dss-loris/battery-board-prototype/battery-board-BOM.xlsx

Index | Quantity | Part Number | Manufacturer Part Number | Description | Customer Reference | Available | Backorder | Unit Price | Extended Price USD
1 | 4 | DB2431200LCT-ND | DB2431200L | DIODE SCHOTTKY 30V 5A TMINIP2 | D1,D2 … BB | 4 | 0 | 0.42 | 1.68
2 | 2 | 2057-2PH1-05-UA-ND | 2PH1-05-UA | CONN HEADER VERT 5POS 2MM | J5,J9 … BB | 2 | 0 | 0.18 | 0.36
3 | 2 | 2057-2PH1-04-UA-ND | 2PH1-04-UA | CONN HEADER VERT 4POS 2MM | J3 … BB | 2 | 0 | 0.14 | 0.28
4 | 2 | 952-1316-ND | M22-2511005 | CONN HEADER VERT 10POS 2MM | J1,J4,CDR1,GND1,MPB1 … BB | 2 | 0 | 0.61 | 1.22
5 | 2 | LM4120AIM5-5.0/NOPBCT-ND | LM4120AIM5-5.0/NOPB | IC VREF SERIES 0.2% SOT23-5 | U1 … BB | 2 | 0 | 2.19 | 4.38
6 | 2 | WM4000-ND | 0022032021 | CONN HEADER VERT 2POS 2.54MM | JP1,JP2 … BB | 2 | 0 | 0.25 | 0.50
7 | 10 | 399-C1206C104K5RAC7800CT-ND | C1206C104K5RAC7800 | CAP CER 0.1UF 50V X7R 1206 | C2,C3,C4,C8,10 … BB | 10 | 0 | 0.088 | 0.88
8 | 2 | 1849-1001-ND | PR20C06VBNN | CONN HEADER VERT 6POS 2MM | J2,J8 … BB | 2 | 0 | 0.16 | 0.32
9 | 2 | 399-8150-1-ND | C1206C105M4RACTU | CAP CER 1UF 16V X7R 1206 | C9 … BB | 2 | 0 | 0.19 | 0.38
10 | 3 | 408-2038-1-ND | RG3216P-5004-B-T1 | RES 5M OHM 0.1% 1/4W 1206 | R4,R5 … BB | 3 | 0 | 0.76 | 2.28
11 | 1 | 36-1042-ND | 1042 | BATTERY HOLDER 18650 SMD TAB | BT1 … BB | 1 | 0 | 2.76 | 2.76
12 | 2 | 399-9329-1-ND | C1206C223J1RACTU | CAP CER 0.022UF 100V X7R 1206 | C1 … BB | 2 | 0 | 0.2 | 0.40
13 | 3 | 399-1251-1-ND | C1206C224K5RACTU | CAP CER 0.22UF 50V X7R 1206 | C5,C7 … BB | 3 | 0 | 0.23 | 0.69
14 | 2 | 311-2007-1-ND | CC1206ZRY5V6BB106 | CAP CER 10UF 10V Y5V 1206 | C6 … BB | 2 | 0 | 0.23 | 0.46
15 | 3 | 732-5316-ND | 61300311121 | CONN HEADER VERT 3POS 2.54MM | J6,J7 … BB | 3 | 0 | 0.13 | 0.39
16 | 5 | RG32P887KBCT-ND | RG3216P-8873-B-T1 | RES SMD 887K OHM 0.1% 1/4W 1206 | R1,R2,R8 … BB | 5 | 0 | 0.68 | 3.40
17 | 2 | P2.2KECT-ND | ERJ-8GEYJ222V | RES SMD 2.2K OHM 5% 1/4W 1206 | R3 … BB | 2 | 0 | 0.1 | 0.20
18 | 2 | P4.87KFCT-ND | ERJ-8ENF4871V | RES SMD 4.87K OHM 1% 1/4W 1206 | R6 … BB | 2 | 0 | 0.1 | 0.20
19 | 2 | P330FCT-ND | ERJ-8ENF3300V | RES SMD 330 OHM 1% 1/4W 1206 | R7 … BB | 2 | 0 | 0.1 | 0.20
20 | 2 | RNCP1206FTD28K0CT-ND | RNCP1206FTD28K0 | RES 28K OHM 1% 1/2W 1206 | R9 … BB | 2 | 0 | 0.1 | 0.20
21 | 4 | P332KFCT-ND | ERJ-8ENF3323V | RES SMD 332K OHM 1% 1/4W 1206 | R19,R22 … BB | 4 | 0 | 0.1 | 0.40
22 | 5 | P187KBCCT-ND | ERA-8AEB1873V | RES SMD 187K OHM 0.1% 1/4W 1206 | R0,R11,R24 … BB | 5 | 0 | 0.66 | 3.30
23 | 2 | 311-1.62MFRCT-ND | RC1206FR-071M62L | RES SMD 1.62M OHM 1% 1/4W 1206 | R12 … BB | 2 | 0 | 0.1 | 0.20
24 | 2 | P374KFCT-ND | ERJ-8ENF3743V | RES SMD 374K OHM 1% 1/4W 1206 | R13 … BB | 2 | 0 | 0.1 | 0.20
25 | 2 | RMCF0805FT1M43CT-ND | RMCF0805FT1M43 | RES 1.43M OHM 1% 1/8W 0805 | R14 … BB | 2 | 0 | 0.1 | 0.20
26 | 2 | P562KFCT-ND | ERJ-8ENF5623V | RES SMD 562K OHM 1% 1/4W 1206 | R15 … BB | 2 | 0 | 0.1 | 0.20
27 | 2 | WSLPB-.014CT-ND | WSLP0805R0140FEB | RES 0.014 OHM 1% 1/2W 0805 | R16 … BB | 2 | 0 | 1.27 | 2.54
28 | 2 | RR08P284KDCT-ND | RR0816P-2843-D-E00 | RES SMD 284K OHM 0.5% 1/16W 0603 | R17 … BB | 2 | 0 | 0.13 | 0.26
29 | 3 | P100KFCT-ND | ERJ-8ENF1003V | RES SMD 100K OHM 1% 1/4W 1206 | R18,R23 … BB | 3 | 0 | 0.1 | 0.30
30 | 2 | P29.4KFCT-ND | ERJ-8ENF2942V | RES SMD 29.4K OHM 1% 1/4W 1206 | R20 … BB | 2 | 0 | 0.1 | 0.20
31 | 2 | P59.0KFCT-ND | ERJ-8ENF5902V | RES SMD 59K OHM 1% 1/4W 1206 | R21 … BB | 2 | 0 | 0.1 | 0.20
32 | 2 | 445-174306-1-ND | NTCG103JX103DT1 | THERMISTOR NTC 10KOHM 3380K 0402 | TH1 … BB | 2 | 0 | 0.23 | 0.46
33 | 4 | 296-25857-1-ND | CSD17307Q5A | MOSFET N-CH 30V 73A 8SON | Q1,Q2 … BB | 4 | 0 | 0.76 | 3.04
34 | 2 | LTC2942CDCB#TRMPBFCT-ND | LTC2942CDCB#TRMPBF | IC FUEL/GAS GAUGE LI-ION 6DFN | U2 … BB | 2 | 0 | 3.86 | 7.72
35 | 4 | 296-37669-6-ND | TPS2557DRBR | IC PWR SWITCH N-CHAN 1:1 8SON | U4,U6 … BB | 4 | 0 | 3.89 | 15.56
36 | 2 | 296-13263-1-ND | SN74LVC2G08DCTR | IC GATE AND 2CH 2-INP SM8 | U7 … BB | 2 | 0 | 0.54 | 1.08
37 | 5 | 296-1015-1-ND | LM393DR | IC DUAL DIFF COMP 8-SOIC | U3,U5 … BB | 5 | 0 | 0.38 | 1.90
38 | 5 | 15291025 | 0015291025 | CONN SHUNT CLOSED TOP .100 GOLD | JUMPERS … BB | 5 | 0 | 0.56 | 2.80
39 | 4 | 296-39948-1-ND | BQ29707DSER | IC LITHIUM BATT PROTECT 6WSON | BQ29707 … BB | 4 | 0 | 0.69 | 2.76
