dss-loris/battery-board-prototype/(list of files, drawings)

Other design files:
Main.dsn
