dss-loris/battery-board-prototype/Main.kicad_pcb

## KiCad design Main.kicad_pcb (2020-01-07)

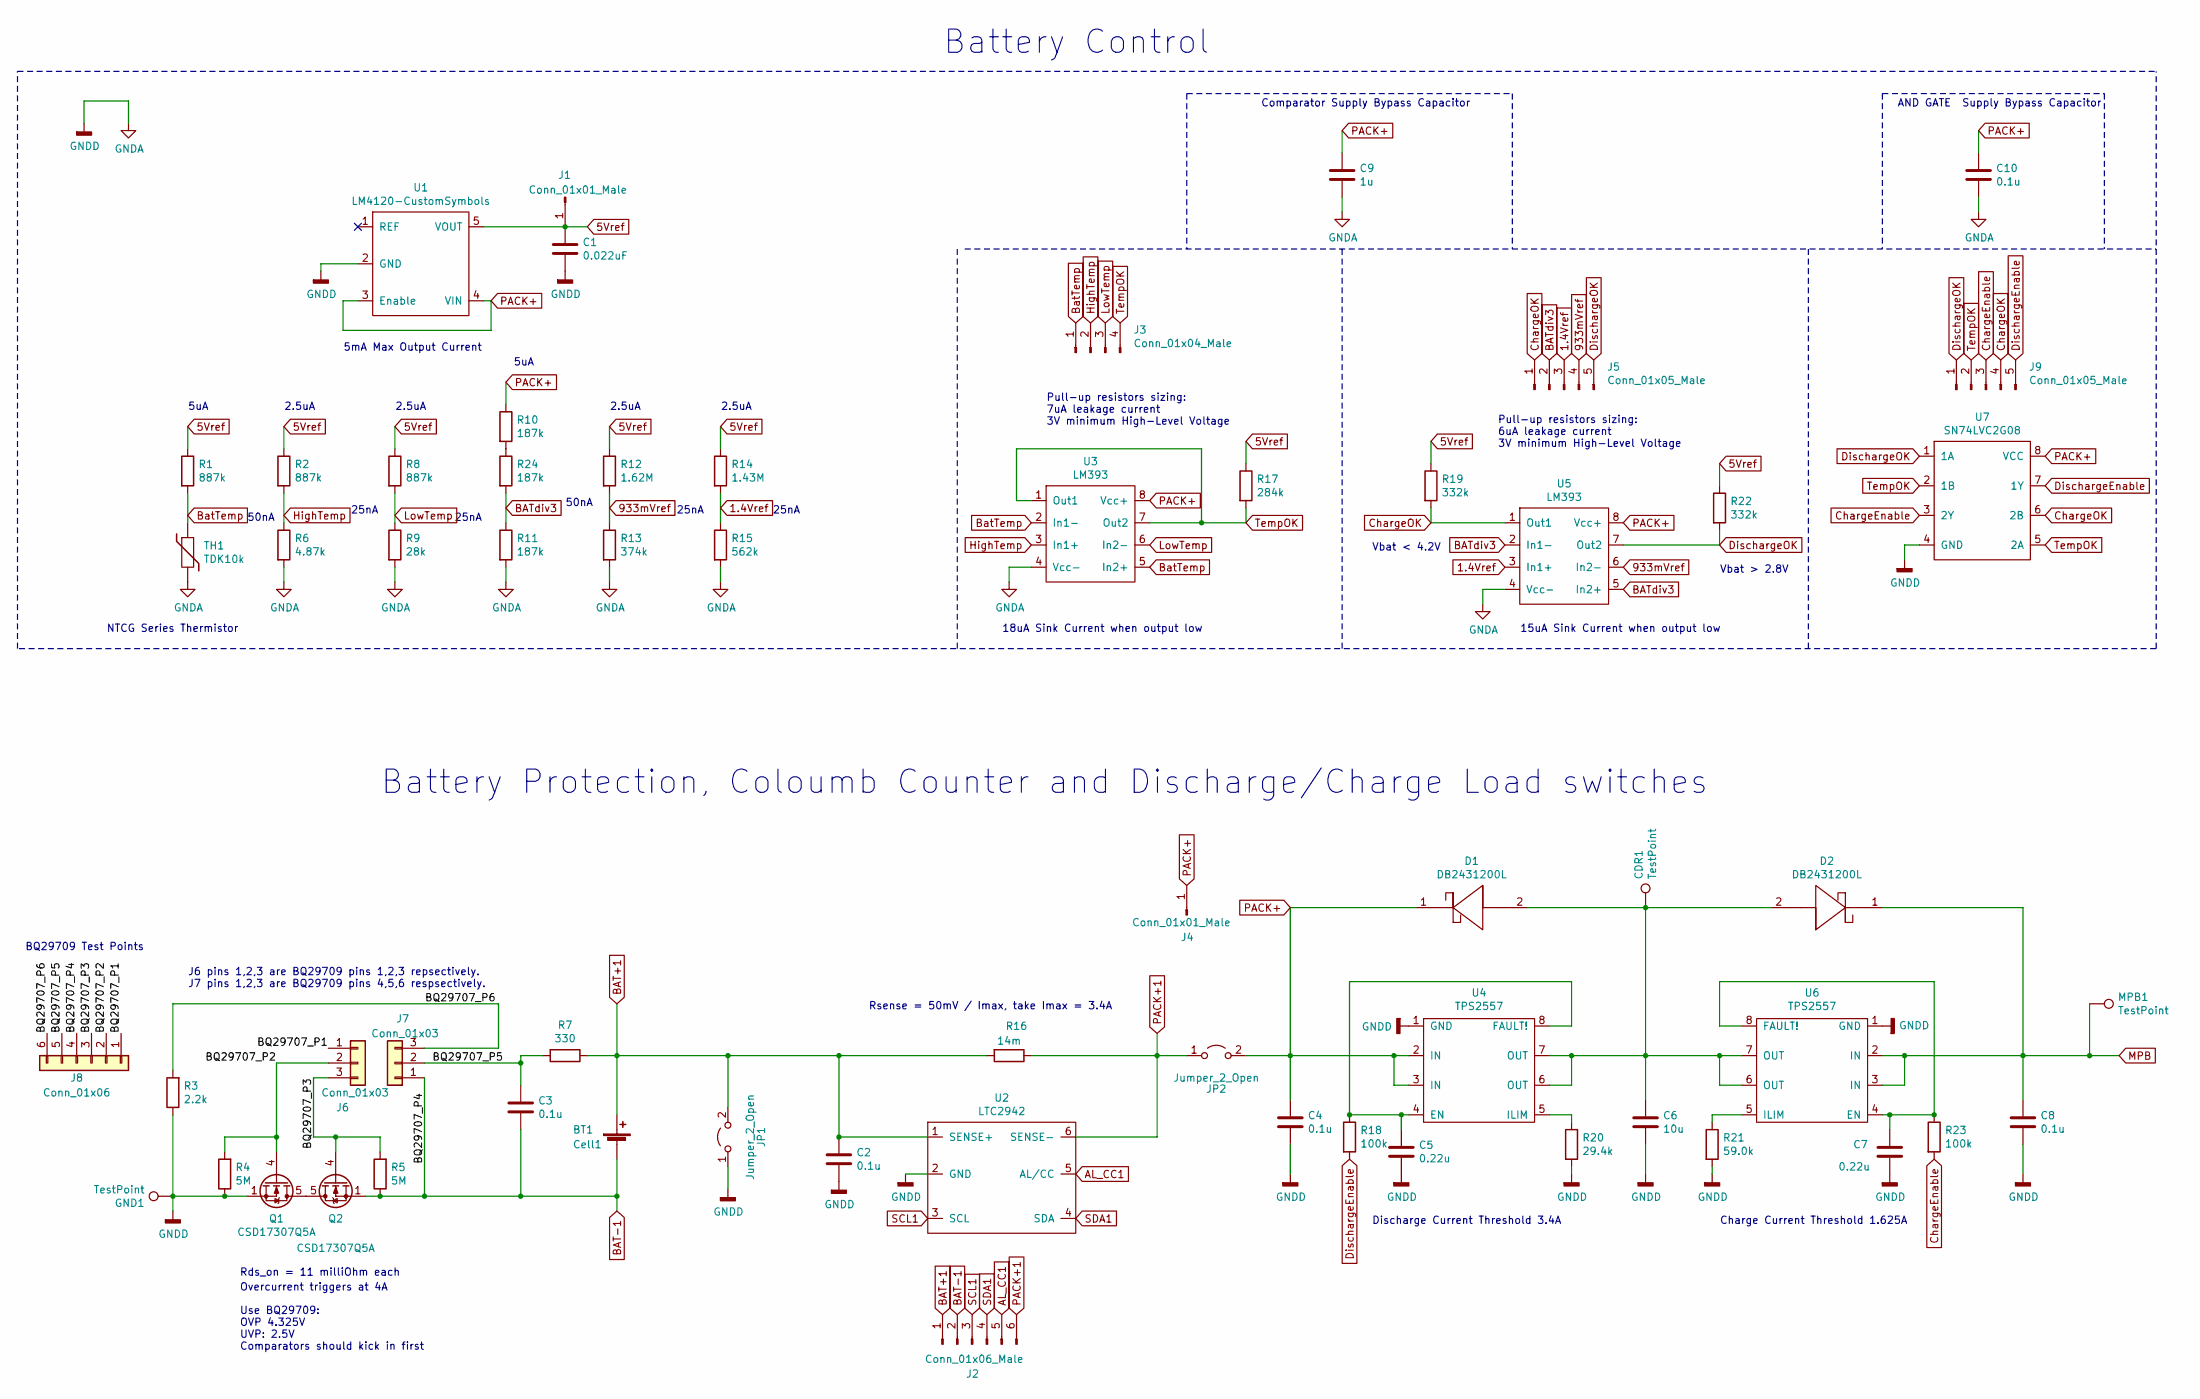
[picture p1: schematic Main.sch, Electrical Power System]

Parts:
BT1: Cell1; BatteryHolder_Keystone_1042_1x18650
C1: 0.022uF; C_1206_3216Metric_Pad1.42x1.75mm_HandSolder
C2, C3, C4, C8, C10: 0.1u; C_1206_3216Metric_Pad1.42x1.75mm_HandSolder
C5, C7: 0.22u; C_1206_3216Metric_Pad1.42x1.75mm_HandSolder
C6: 10u; C_1206_3216Metric_Pad1.42x1.75mm_HandSolder
C9: 1u; C_1206_3216Metric_Pad1.42x1.75mm_HandSolder
CDR1: TestPoint; PinHeader_1x01_P2.00mm_Vertical
D1, D2: DB2431200L
GND1: TestPoint; PinHeader_1x01_P2.00mm_Vertical
J1, J4: Conn_01x01_Male; PinHeader_1x01_P2.00mm_Vertical
J2: Conn_01x06_Male; PinSocket_1x06_P2.00mm_Vertical
J3: Conn_01x04_Male; PinHeader_1x04_P2.00mm_Vertical
J5, J9: Conn_01x05_Male; PinHeader_1x05_P2.00mm_Vertical
J6, J7: Conn_01x03; PinSocket_1x03_P2.54mm_Vertical
J8: Conn_01x06; PinHeader_1x06_P2.00mm_Vertical
JP1, JP2: Jumper_2_Open; PinSocket_1x01_P2.54mm_Vertical
MPB1: TestPoint; PinHeader_1x01_P2.00mm_Vertical
Q1, Q2: CSD17307Q5A; TDSON-8-1
R1, R2, R8: 887k; R_1206_3216Metric_Pad1.42x1.75mm_HandSolder
R3: 2.2k; R_1206_3216Metric_Pad1.42x1.75mm_HandSolder
R4, R5: 5M; R_1206_3216Metric_Pad1.42x1.75mm_HandSolder
R6: 4.87k; R_1206_3216Metric_Pad1.42x1.75mm_HandSolder
R7: 330; R_1206_3216Metric_Pad1.42x1.75mm_HandSolder
R9: 28k; R_1206_3216Metric_Pad1.42x1.75mm_HandSolder
R10, R11, R24: 187k; R_1206_3216Metric_Pad1.42x1.75mm_HandSolder
R12: 1.62M; R_1206_3216Metric_Pad1.42x1.75mm_HandSolder
R13: 374k; R_1206_3216Metric_Pad1.42x1.75mm_HandSolder
R14: 1.43M; R_0805_2012Metric_Pad1.15x1.40mm_HandSolder
R15: 562k; R_1206_3216Metric_Pad1.42x1.75mm_HandSolder
R16: 14m; R_0805_2012Metric
R17: 284k; R_0603_1608Metric_Pad1.05x0.95mm_HandSolder
R18, R23: 100k; R_1206_3216Metric_Pad1.42x1.75mm_HandSolder
R19, R22: 332k; R_1206_3216Metric_Pad1.42x1.75mm_HandSolder
R20: 29.4k; R_1206_3216Metric_Pad1.42x1.75mm_HandSolder
R21: 59.0k; R_1206_3216Metric_Pad1.42x1.75mm_HandSolder
TH1: TDK10k; R_0402_1005Metric
U1: LM4120-CustomSymbols; SOT-23-5_HandSoldering
U2: LTC2942; DFN-6-1EP_3x2mm_P0.5mm_EP1.65x1.35mm
U3, U5: LM393; SOIC-8-1EP_3.9x4.9mm_P1.27mm_EP2.29x3mm
U4, U6: TPS2557
U7: SN74LVC2G08; SN74LVC2G08DCTR

Connections:
1.4Vref: J5.3, R14.2, R15.1, U5.3 (In1+)
5Vref: C1.1, J1.1, R1.1, R2.1, R8.1, R12.1, R14.1, R17.1, R19.1, R22.1, U1.5 (VOUT)
933mVref: J5.4, R12.2, R13.1, U5.6 (In2-)
/BQ29707_P1: J6.1, J8.1
/BQ29707_P2: J6.2, J8.2, Q1.4 (G), R4.2
/BQ29707_P3: J6.3, J8.3, Q2.4 (G), R5.2
/BQ29707_P5: C3.1, J7.2, J8.5, R7.2
/BQ29707_P6: J7.3, J8.6, R3.2
AL_CC1: J2.5, U2.5 (AL/CC)
BAT+1: BT1.1 (+), C2.1, J2.1, JP1.2 (B), R7.1, R16.2, U2.1 (SENSE+)
BAT-1: BT1.2 (-), C3.2, J2.2, J7.1, J8.4, Q2.1 (S), Q2.2 (S), Q2.3 (S), R5.1
BATdiv3: J5.2, R11.1, R24.2, U5.2 (In1-), U5.5 (In2+)
BatTemp: J3.1, R1.2, TH1.1, U3.2 (In1-), U3.5 (In2+)
ChargeEnable: J9.3, R23.2, U7.3 (2Y)
ChargeOK: J5.1, J9.4, R19.2, U5.1 (Out1), U7.6 (2B)
DischargeEnable: J9.5, R18.2, U7.7 (1Y)
DischargeOK: J5.5, J9.1, R22.2, U5.7 (Out2), U7.1 (1A)
GNDA: C1.2, C2.2, C4.2, C5.2, C6.2, C7.2, C8.2, C9.2, C10.2, GND1.1, JP1.1 (A), Q1.1 (S), Q1.2 (S), Q1.3 (S), R3.1, R4.1, R6.2, R9.2, R11.2, R13.2, R15.2, R20.2, R21.2, TH1.2, U1.2 (GND), U2.2 (GND), U3.4 (Vcc-), U4.1 (GND), U5.4 (Vcc-), U6.1 (GND), U7.4 (GND)
HighTemp: J3.2, R2.2, R6.1, U3.3 (In1+)
LowTemp: J3.3, R8.2, R9.1, U3.6 (In2-)
MPB: C8.1, D2.1, MPB1.1, U6.2 (IN), U6.3 (IN)
unnamed: C5.1, R18.1, U4.4 (EN), U4.8 (FAULT!)
unnamed: C6.1, CDR1.1, D1.2, D2.2, U4.6 (OUT), U4.7 (OUT), U6.6 (OUT), U6.7 (OUT)
unnamed: C7.1, R23.1, U6.4 (EN), U6.8 (FAULT!)
unnamed: Q1.5 (D), Q2.5 (D)
unnamed: R10.2, R24.1
unnamed: R20.1, U4.5 (ILIM)
unnamed: R21.1, U6.5 (ILIM)
PACK+: C4.1, C9.1, C10.1, D1.1, J4.1, JP2.2 (B), R10.1, U1.3 (Enable), U1.4 (VIN), U3.8 (Vcc+), U4.2 (IN), U4.3 (IN), U5.8 (Vcc+), U7.8 (VCC)
PACK+1: J2.6, JP2.1 (A), R16.1, U2.6 (SENSE-)
SCL1: J2.3, U2.3 (SCL)
SDA1: J2.4, U2.4 (SDA)
TempOK: J3.4, J9.2, R17.2, U3.1 (Out1), U3.7 (Out2), U7.2 (1B), U7.5 (2A)

Notes on the sheet:
Rds_on = 11 milliOhm each
Overcurrent triggers at 4A
Discharge Current Threshold 3.4A
Charge Current Threshold 1.625A
2.5uA
5uA
25nA
50nA
5mA Max Output Current
NTCG Series Thermistor
Vbat > 2.8V
Vbat < 4.2V
Use BQ29709: OVP 4.325V UVP: 2.5V Comparators should kick in first
Pull-up resistors sizing: 6uA leakage current 3V minimum High-Level Voltage
Pull-up resistors sizing: 7uA leakage current 3V minimum High-Level Voltage
18uA Sink Current when output low
15uA Sink Current when output low
Comparator Supply Bypass Capacitor
AND GATE Supply Bypass Capacitor
Battery Control
Battery Protection, Coloumb Counter and Discharge/Charge Load switches
BQ29709 Test Points
Rsense = 50mV / Imax, take Imax = 3.4A
J6 pins 1,2,3 are BQ29709 pins 1,2,3 repsectively. J7 pins 1,2,3 are BQ29709 pins 4,5,6 respsectively.

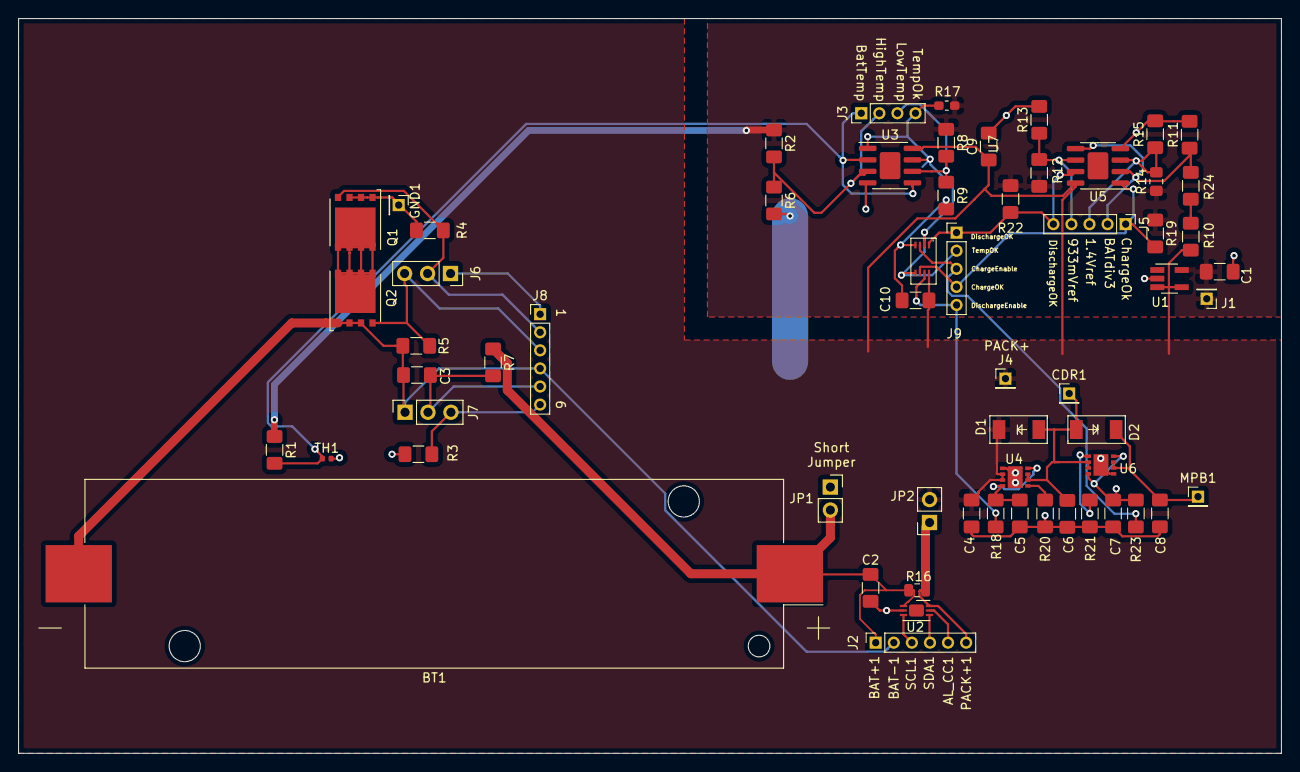
[picture p2: board Main.kicad_pcb from above]

Board: 2 copper layers, 139.7 x 81.3 mm, 61 parts (0 on the bottom side), 33 nets.
