dss-loris/battery-board-prototype/(commit log)

2019-12-05 annotated schematic
    [Main-B_Cu.gbr, Main-B_Mask.gbr, Main-B_Paste.gbr, Main-B_SilkS.gbr, Main-Edge_Cuts.gbr, Main-F_Cu.gbr, Main-F_Mask.gbr, Main-F_Paste.gbr]
2019-12-05 Added footprints for symbols, need to find schottkys
    [Main.sch, _saved_Main.sch]
2019-12-05 started layout
    [Main.kicad_pcb]
2019-12-05 added txt
    [Main.sch]
2019-12-05 Changed Comparator supply to Pack+. Changed pull-up resistor supply from Pack to 5Vref, changed values of pull-up resistors.
    [Main.sch]
2019-12-07 worked on pcb
    [Main.kicad_pcb, Main.sch]
2019-12-12 changed test points
    [Main.kicad_pcb, Main.sch]
